charithssale/ESP32-Universal-PLC-Protocol-Bridge/Images/Result_plot.jpg

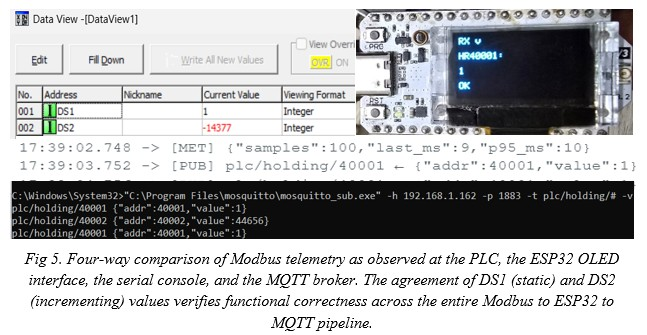
Images/Result_plot.jpg
