charithssale/ESP32-Universal-PLC-Protocol-Bridge/Hardware/Schematic_Diagram.pdf

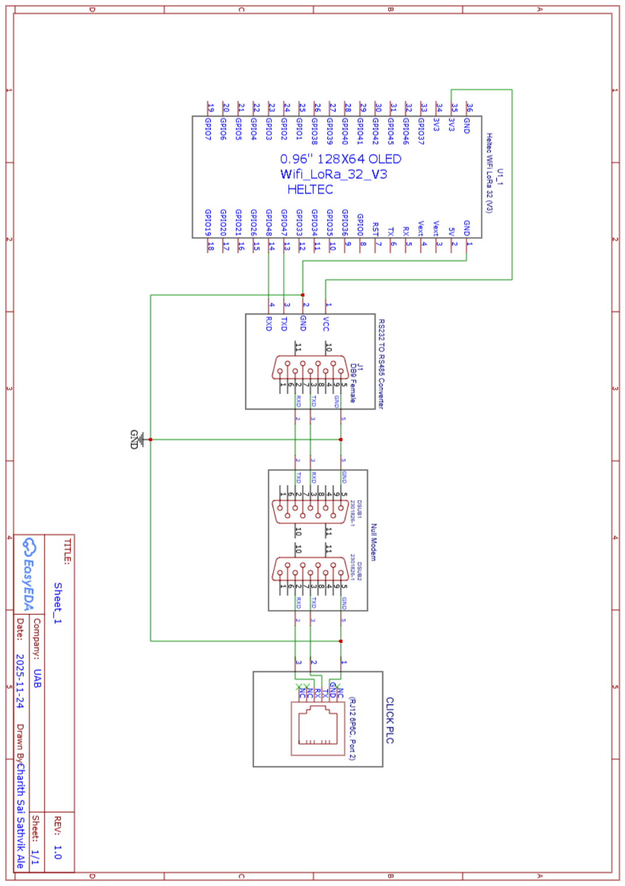
[picture p23: page 1]
