charithssale/ESP32-Universal-PLC-Protocol-Bridge/Images/Comparison_TableRS232VS485.jpg

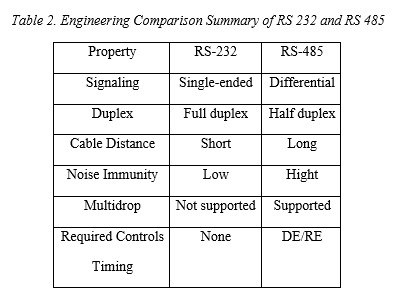
Images/Comparison_TableRS232VS485.jpg
