charithssale/ESP32-Universal-PLC-Protocol-Bridge/Images/Deterministic_Behavior.jpg

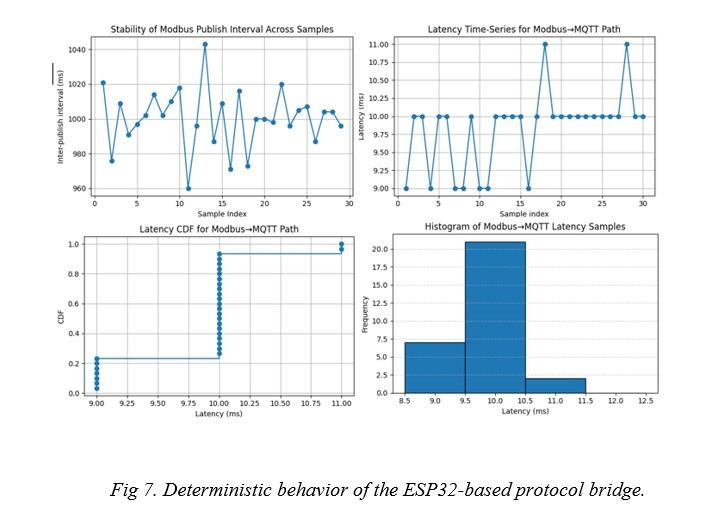
Images/Deterministic_Behavior.jpg
