charithssale/ESP32-Universal-PLC-Protocol-Bridge/Images/Flowchart.jpg

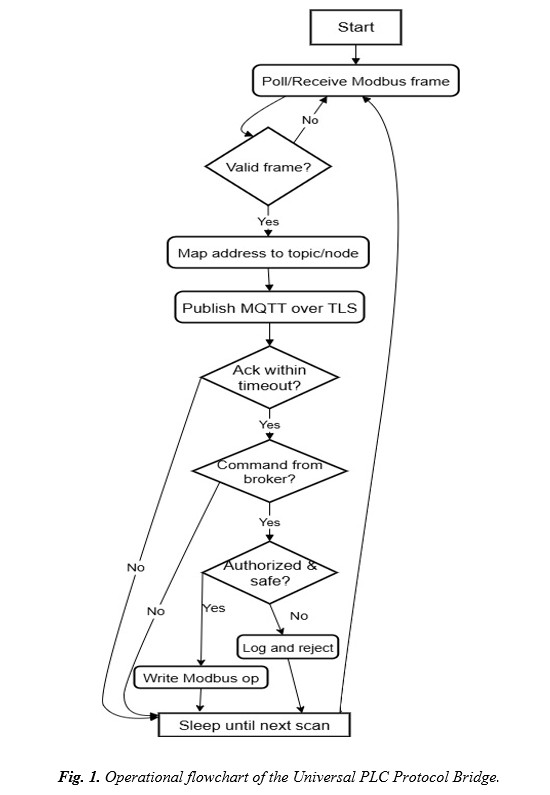
Images/Flowchart.jpg
