charithssale/ESP32-Universal-PLC-Protocol-Bridge/Images/Latency&jitter.jpg

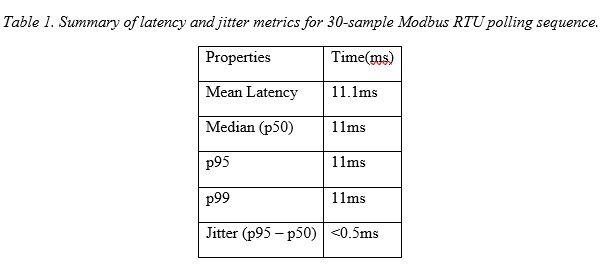
Images/Latency&jitter.jpg
