charithssale/ESP32-Universal-PLC-Protocol-Bridge/Images/Protocol_Bridge_Block_Diagram.jpg

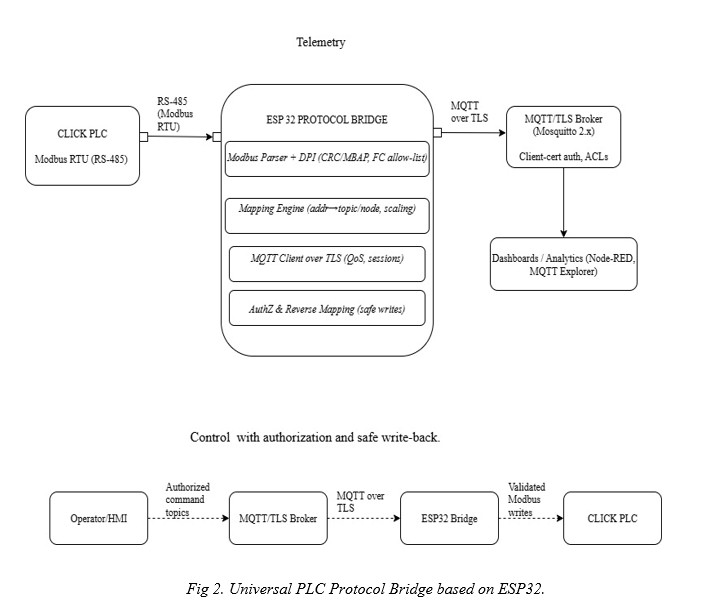
Images/Protocol_Bridge_Block_Diagram.jpg
